madfrozen/penplotter/Assets/Circuit_Diagram.pdf

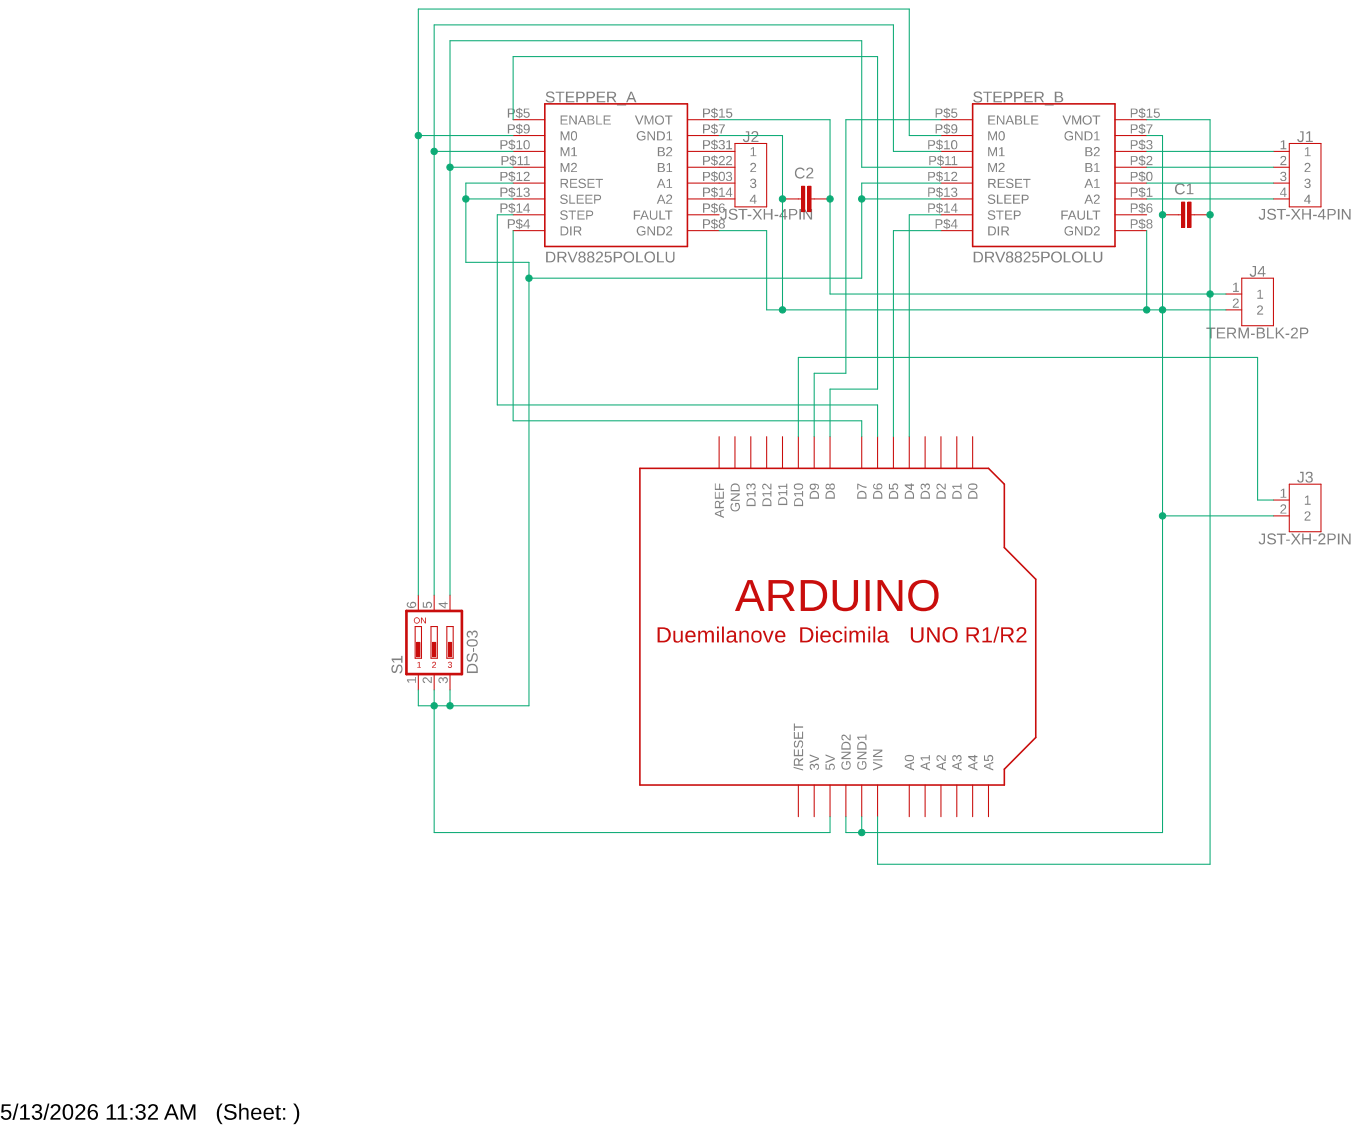
[picture p12: page 1]
