madfrozen/penplotter/Assets/PenPlotter_Drawing_Set.pdf

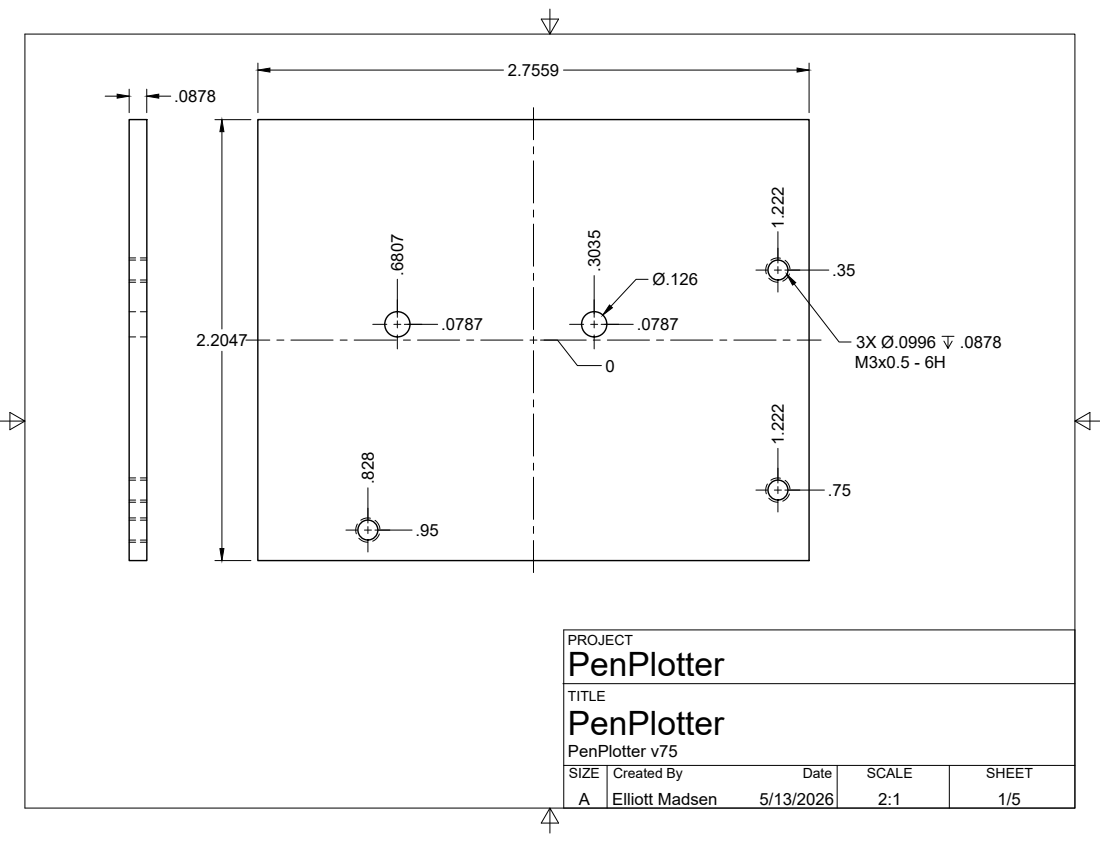
[picture p13: page 1]
SIZE; Created By; Date; SCALE; SHEET; PenPlotter v75; Elliott Madsen

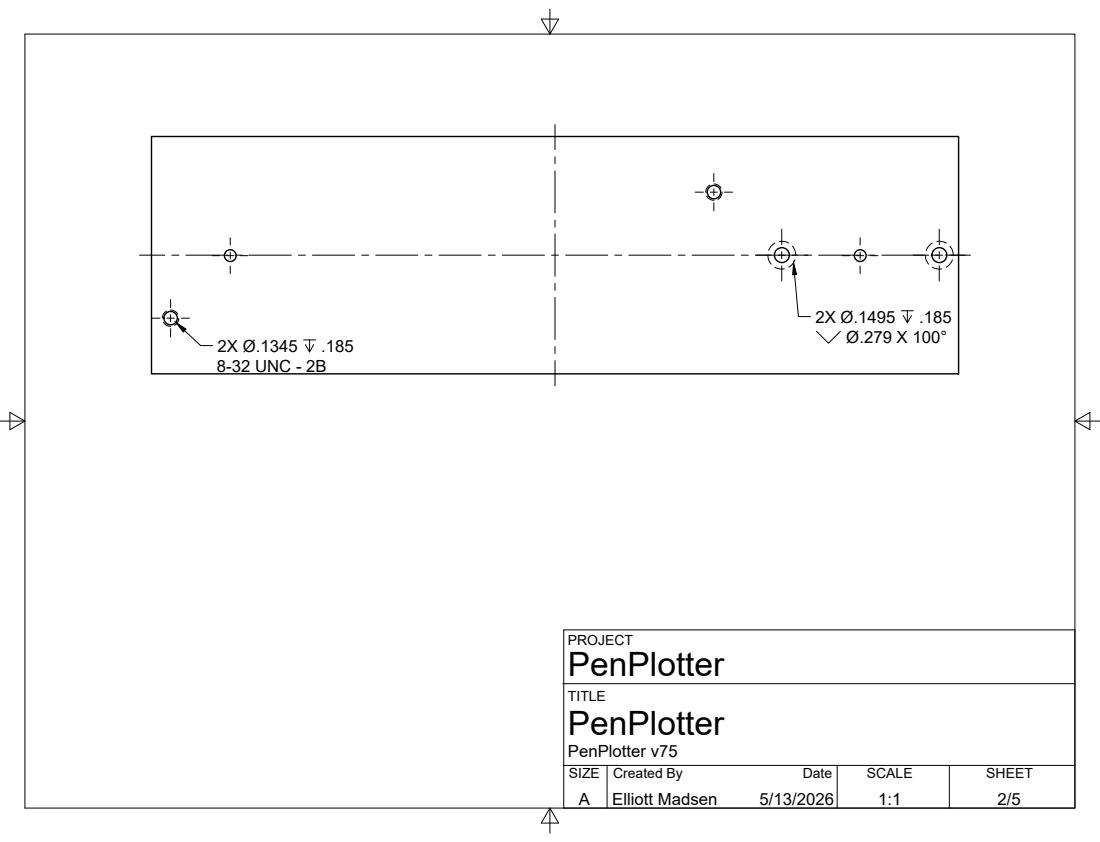
[picture p14: page 2]
SIZE; Created By; Date; SCALE; SHEET; PenPlotter v75; Elliott Madsen; 8-32 UNC - 2B

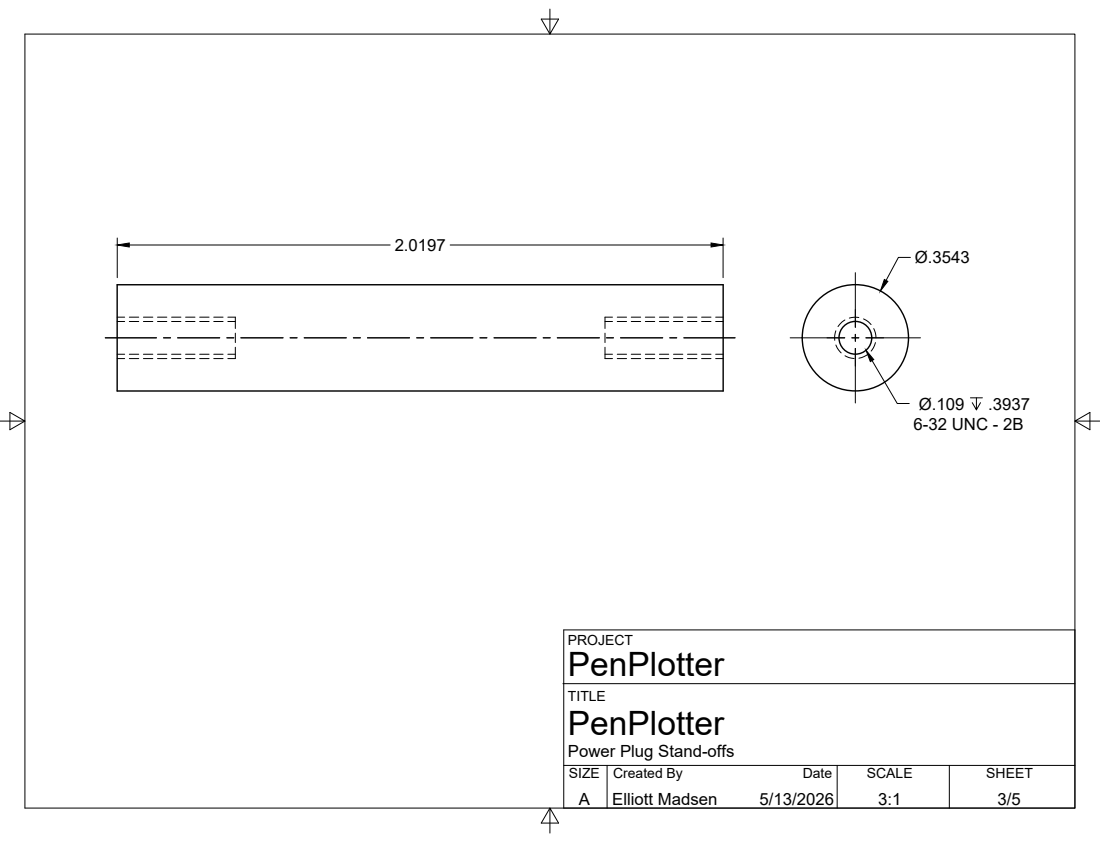
[picture p15: page 3]
SIZE; Created By; Date; SCALE; SHEET; Elliott Madsen; 6-32 UNC - 2B

Power Plug Stand-offs

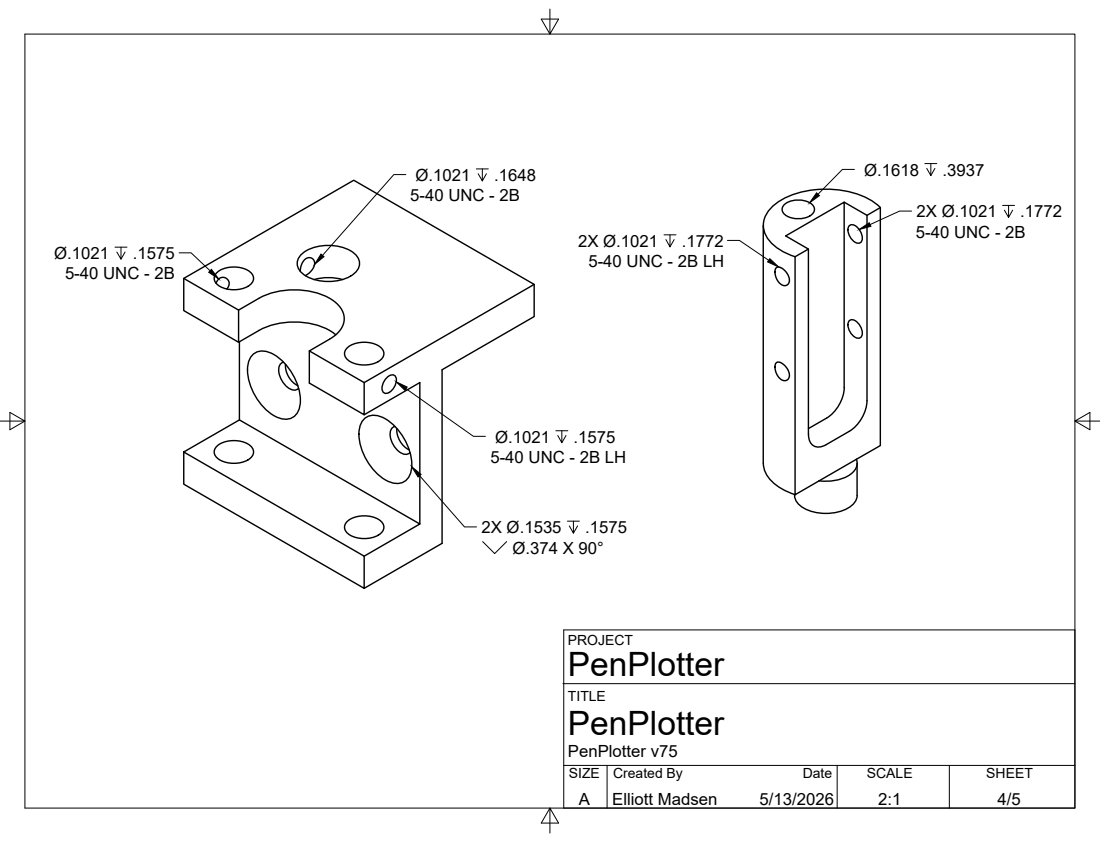
[picture p16: page 4]
SIZE; Created By; Date; SCALE; SHEET; PenPlotter v75; 5-40 UNC - 2B LH; 5-40 UNC - 2B

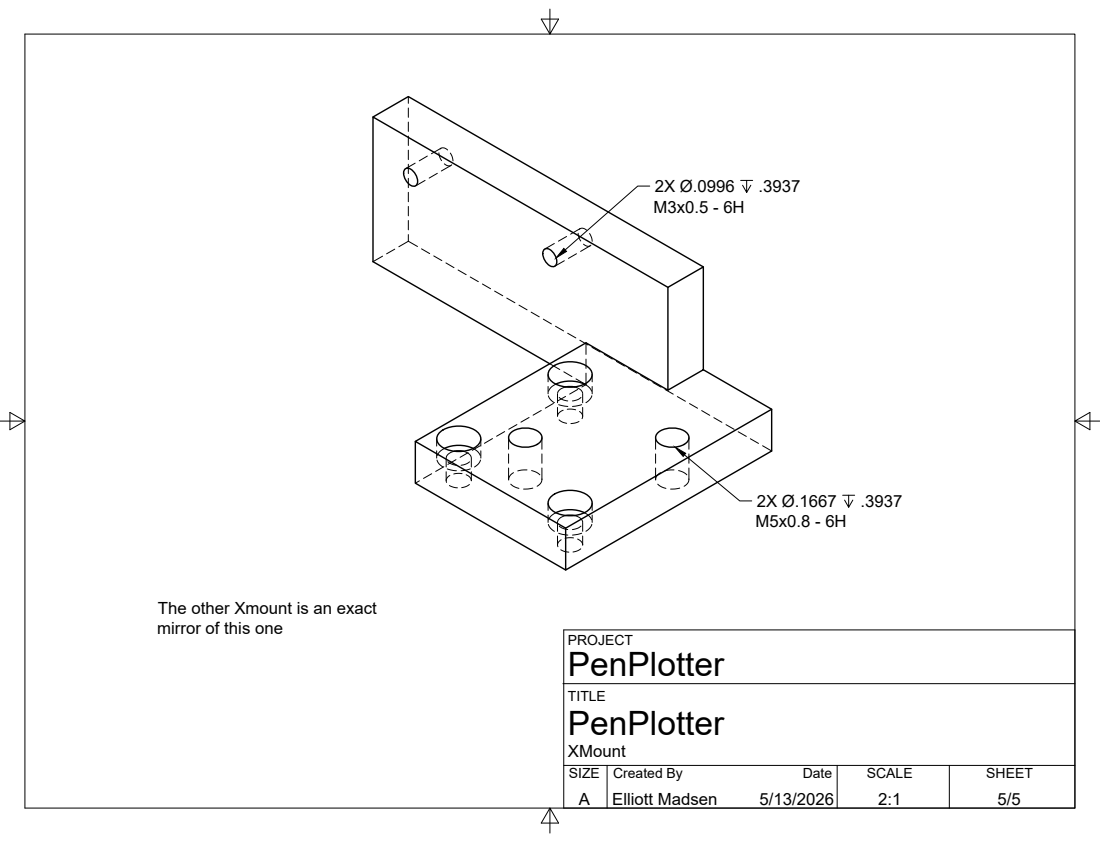
[picture p17: page 5]
SIZE; Created By; Date; SCALE; SHEET

The other Xmount is an exact
mirror of this one
