madfrozen/penplotter/(commit log)

2026-04-14 removed Monitor Commands and added G90 and G91 commands and unhandled GCODE error
    [sketch.ino]
2026-04-14 increaed timer to 10 seconds
2026-04-15 boiler plate for master script
2026-04-15 added current files to tree
2026-04-16 added rotation to pdf so that it prints right side up
2026-05-01 curently hanging when trying to run a move command after switching to relative movement
2026-05-06 relative mdoe fixed, when absolute_mode = false feedrate was getting set to 0 through the parseparam function
    [sketch.ino]
2026-05-07 moved print lin in python so it occurs after spaces have been removed
2026-05-13 Added Drawings and CAD Files
